MikeT-02/ProiectCEF-ERS/README.md

Proiect Circuite Electronice - Stabilizator de tensiune cu Element de reglaj Serie (ERS)
Proiectul a fost realizat folosind aplicatia OrCAD Capture CIS Lite

Fisierul "layout.opj" contine schema circuitului cu urmatoarele caracteristici:
Tensiune de iesire reglabila in intervalul: 3.66 - 5.5 [V];
Sarcina la iesire: 550 [Ω];
Deriva termica a tensiunii de iesire: <2 mV/°C;
Protectie la suprasarcina prin limitarea curentului tranzistorului element de reglaj serie la maxim 0.4 [A];
Tensiunea de intrare in intervalul: 7.33 - 8.25 [V];
Domeniul temperaturilor de functionare: 0° - 70° C;
Amplificarea in tensiune minima (in bucla deschisa) a amplificatorului de eroare: minim 200;
Circuit alimentat de la o sursa de tensiune simpla;
S-au folosit exclusiv componente discrete, fara circuite integrate;

Fisierul "LAYOUT.brd" contine realizarea in tehnologie PCB a schemei circuitului prezentat mai sus, avand urmatoarele caracteristici:
Dimensiunile PCB: 40mm x 40mm;
Material FR4, dublu strat, grosimea foliei de cupru 18um, grosimea placii 1.5mm;

Fisierul "STAB_TST_11.BOM" contine BOM-ul (Bill of Materials) aferent schemei circuitului;

Fisierul "Documentatie ProiectCEF ERS.pdf" contine o scurta descriere aferenta schemei circuitului in format PDF, realizata conform cerintelor profesorilor coordonatori de la facultarea la care studiez la momentul redactarii acestei descrieri (2025);
