MikeT-02/ProiectCEF-ERS/Documentatie ProiectCEF ERS.pdf

UNIVERSITATEA POLITEHNICA BUCURESTI

Facultatea de Electronica Telecomunicatii si Tehnologia Informatiei

### Proiect Dispozitive si Circuite Electronice

### Stabilizator de tensiune cu Element de Reglaj Serie(ERS)

Student: Trifu Mihai-Alexandru | Profesori Coordonatori:
Grupa: 433C | s.I. Dr. Ing. Miron Cristea
| Dr.Ing. Niculina Drăghici

An universitar: 2024-2025

### 1. Date inițiale de proiectare

Se proiectează un stabilizator de tensiune cu următoarele caracteristici:

N = 11

- Tensiunea de ieșire reglabilă în intervalul: N/3-N/2 [V] -> 3.66V-5.5V;
- Element de reglaj serie;
- Sarcina la ieșire: 50N [Ω] -> 550 Ω;
- Deriva termică a tensiunii de ieșire <2mV/ grad C;
- Protecție la suprasarcină prin limitarea curentului tranzistorului element de reglaj serie la maxim 0.4A;
- Tensiunea de intrare în intervalul: 2/3N-3/4N [V] -> 7.33V-8.25V;
- Domeniul temperaturilor de funcționare: 0°−70°C;
- Amplificarea în tensiune minimă (în buclă deschisă) a amplificatorului de eroare: minim 200;
- Se va determina factorul de stabilizare S;
- Circuitul va fi alimentat de la o sursă de tensiune simplă;
- Se folosesc componente discrete, nu se folosesc circuite integrate.

1

### 2. Schema bloc

Pentru a controla si a ține stabilă valoarea tensiunii de la ieșire, vom utiliza o rețea de reacție negativă globală, această rețea de reacție culege o fracțiune din semnalul de la ieșire si îl întoarce la intrarea inversoare pentru a închide bucla.

Rețeaua de reacție negativă face ca valoarea tensiunii sa depindă doar de valoarea unor componente pasive si de tensiunea de referință, astfel încât sa nu depindă de alți factori.

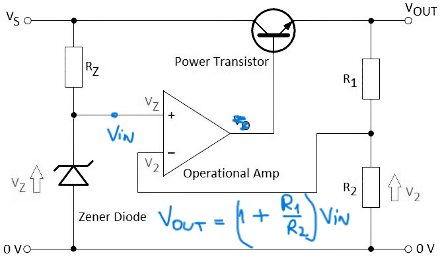
[picture p1: figure]

2

### 3. Proiectarea blocurilor

3.1REFERINTA DE TENSIUNE

Referinta de tensiune de pe borna pozitiva a amplificatorului de eroare este reprezentata din dioda Zener D6, respectiv R29 si R30.

Pe dioda Zener D6 cade o tensiune de 2.7 V, aceasta reprezentand tensiunea de referinta a amplificatorului de eroare.

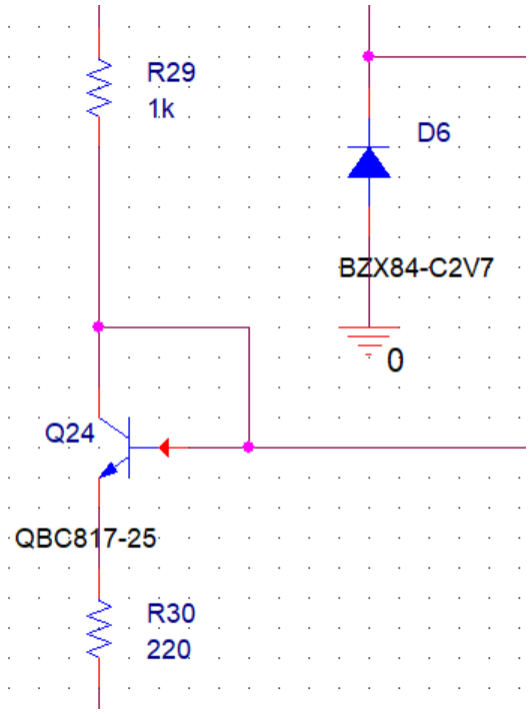
[picture p2: figure]

3

### 3.2 REȚEAUA DE REACȚIE NEGATIVĂ

E constituita din rezistentele R6, R12, R37, R38, R9 si R34 și din potențiometrul P1.

Relația de la ieșire: Vout = (1+(R6+R12+R37)/(R38+R9+R34))*Vin

Prin modificarea valorii SET din potențiometrul P1: se schimba valoarea tensiunii de la ieșire, conform schemei bloc. (dependentă formula de cele 3 rezistente).

4

### 3.3 ELEMENTUL DE REGLAJ SERIE

QESR - QESR2 = al doilea etaj de amplificare in conexiune Darlington, reprezinta si elementul de reglaj serie.

Tranzistorul QESR-QESR2 care reprezinta elementul de reglaj serie este un tranzistor de putere care poate mentine o disipare de putere, implicit un VCE marit, pentru a nu se arde.

5

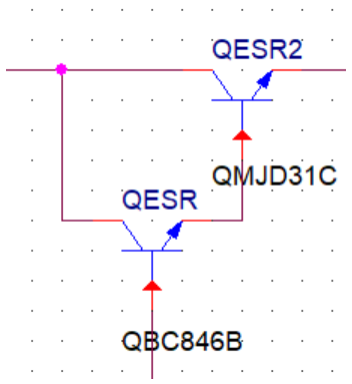
[picture p3: figure]

### 3.4 Circuitul de protecție

Formatiunea formata din QSARCINA, RC1,2,3,4 are rolul de a limita o suprasarcina, adica un curent marit prin sarcina circuitului. Cu cat curentul creste, caderea de tensiune pe rezistente creste, ceea ce duce la deschiderea tranzistorului QSARCINA, si prin comutarea sa in ON se opreste functionarea circuitului. In functionare normala,
QSARCINA este OFF.

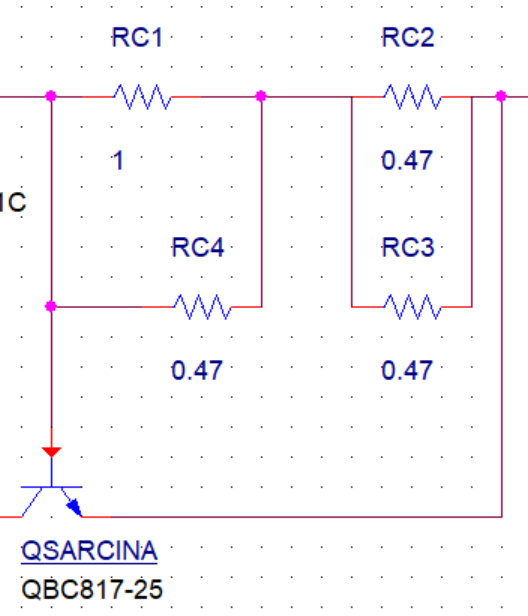
[picture p4: figure]

6

### 4. Schema electrică a montajului electric

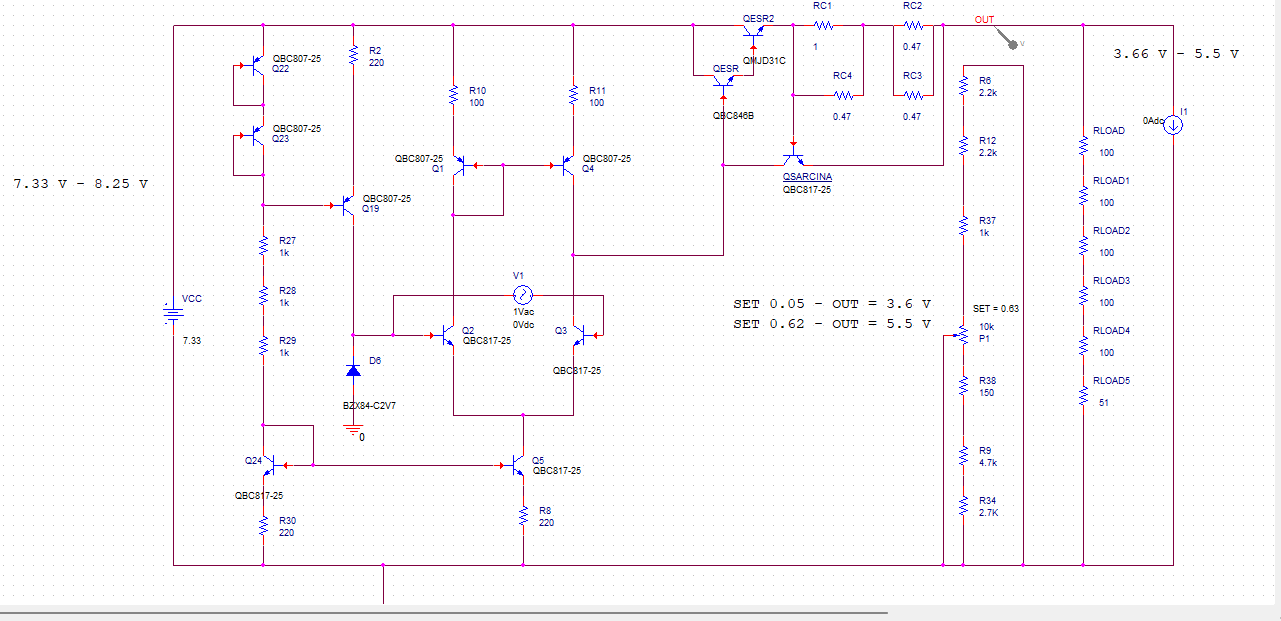
[picture p5: figure]

Roluri și componente:

Q3 și Q2 etaj diferențial de tip NPN -> etaj care amplifica in tensiune si curent;

Q1 si Q4 sarcina activa a etajului diferential, egaleaza curentii pe cele 2 ramuri ale acestuia;

Q1 = referinta de oglinda/transistor dioda de tip PNP -> permite sa iesi din etajul diferential asimetric, deci nu se injumatateste amplificarea etajului;

Rezistoarele R10 SI R11 se numesc rezistente de degenerare si au rol de stabilitate termica;

Etajele de amplificare – pentru a funcționa au nevoie de un curent constant;

Sursa de curent Q5 polarizeaza etajul diferential;

Curentul generat se realizeaza cu ajutorul ramurei Q23 - Q22 - R27 - R28 - R29 - Q24 -R30;

Pe tranzitoarele Q22 si Q23 in conexiune dioda cade cate o tensiune VBE;

Tranzistorul Q24 este referinta de oglinda din oglinda Q24-Q5;

Tranzistorul Q5 copiaza curentul si il ofera pentru a polariza etajul diferential;

7

### 5. Punctul static de funcționare

5.1Punctul static de funcționare pentru tensiune

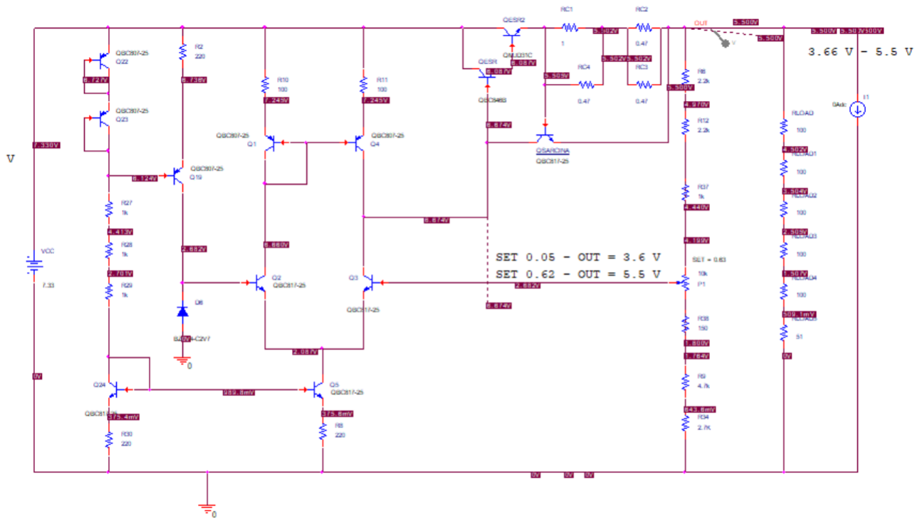
[picture p6: figure]

8

5.2Punctul static de funcționare pentru curenți

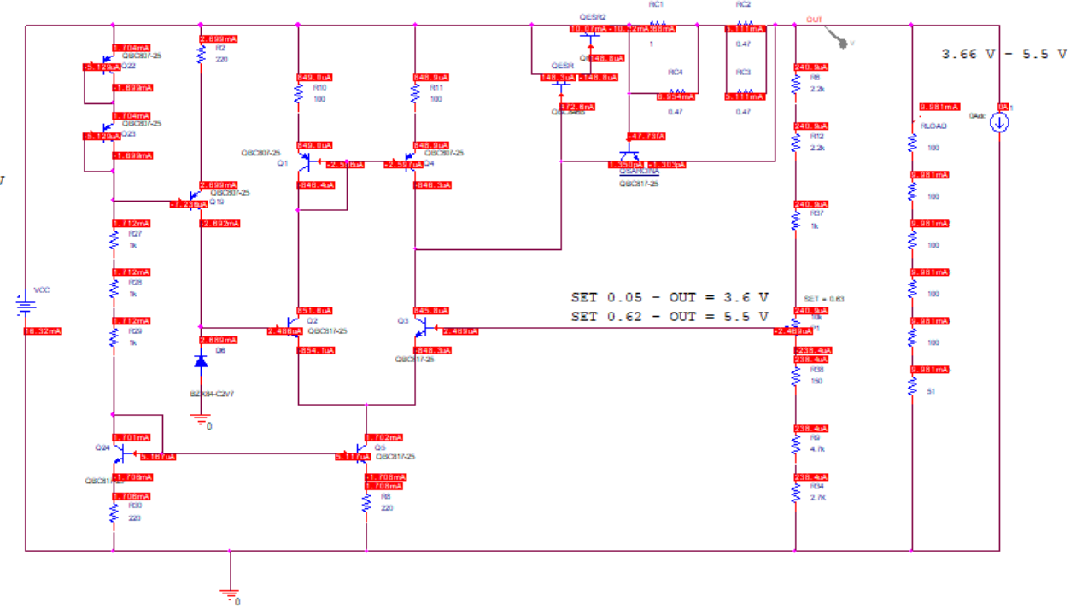
[picture p7: figure]

9

5.3Punctul static de funcționare pentru putere

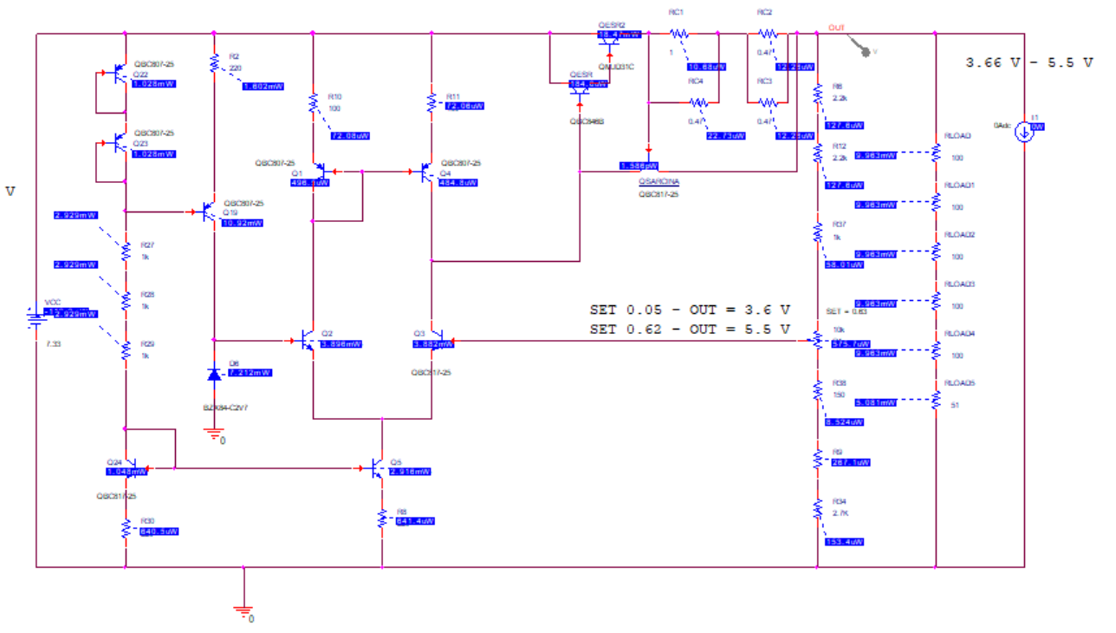
[picture p8: figure]

10

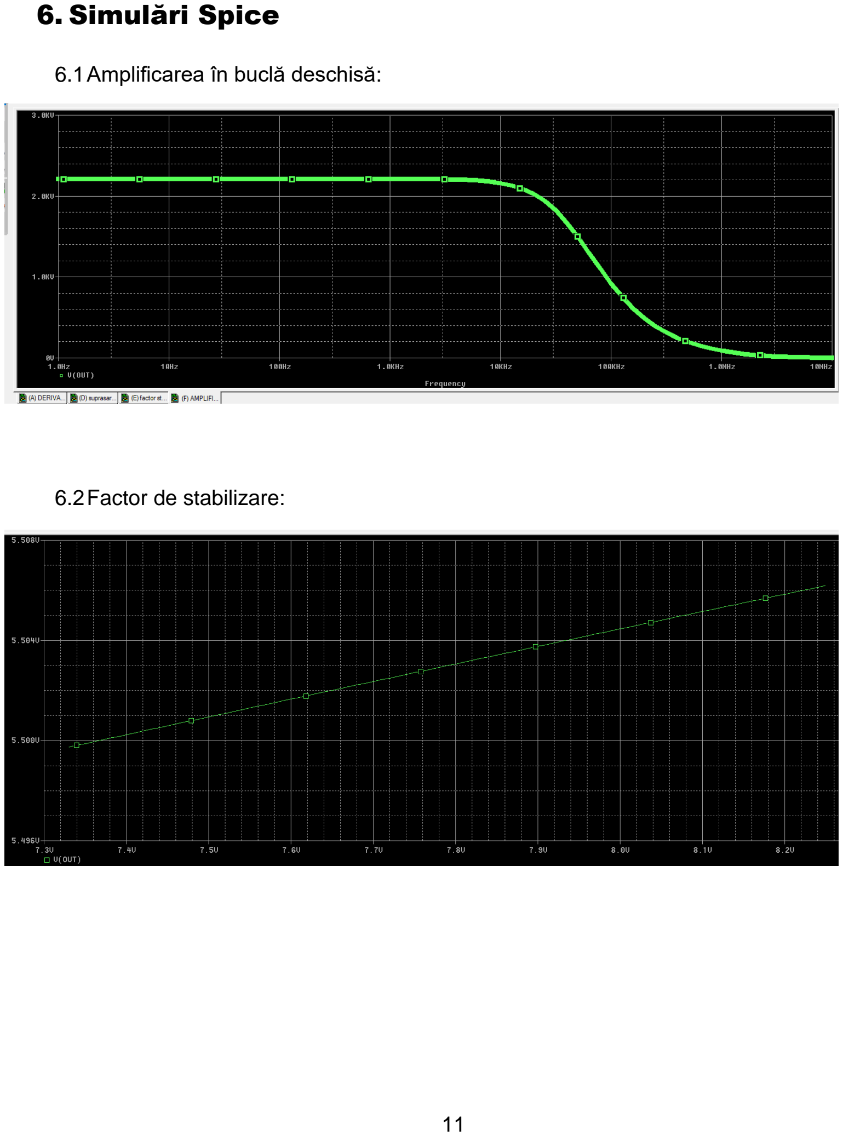
[picture p9: page 12]

### 6. Simulări Spice

6.1Amplificarea în buclă deschisă:

6.2Factor de stabilizare:

11

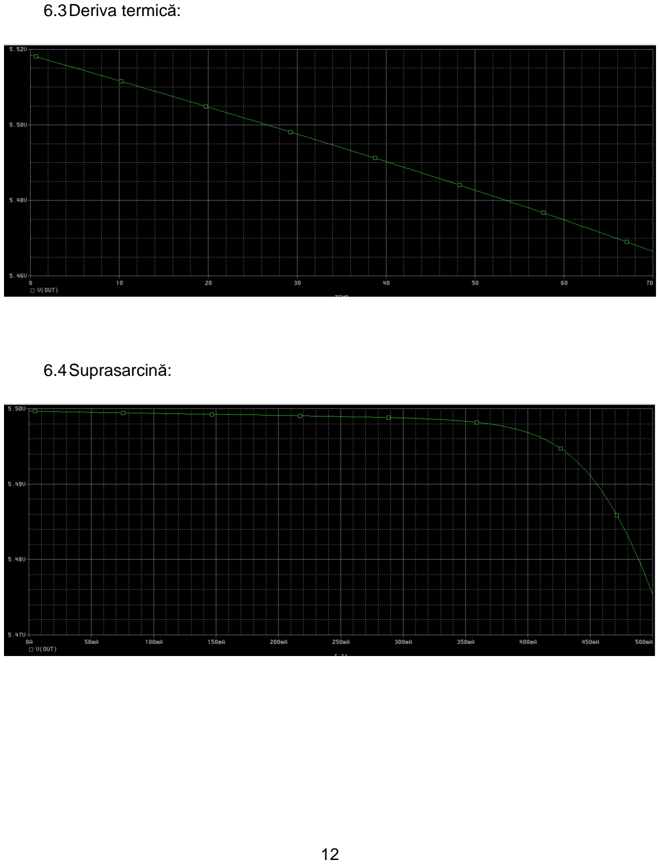
[picture p10: page 13]

6.3Deriva termică:

6.4Suprasarcină:

12

### 7. Bill of materials

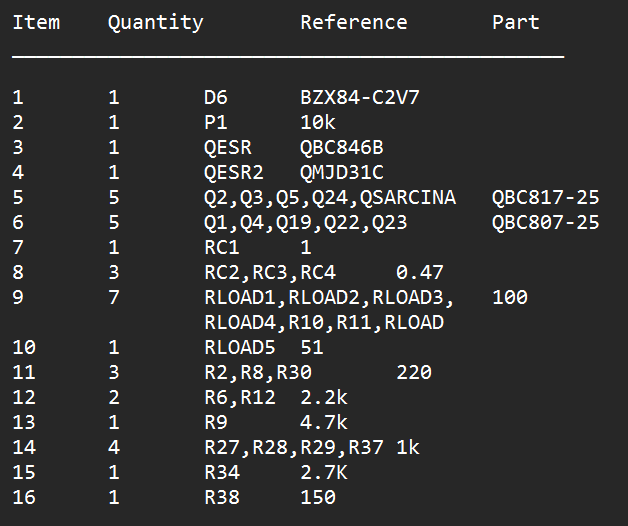
[picture p11: figure]

13

### 8. Bibliografie

- CODREANU N., PANTAZICĂ M., IONESCU C., MARCU A., Tehnici CAD de realizarea modulelor electronice, București, Editura CAVALLIOTI, 2017
- BREZEANU GH., DRĂGHICI F., DILIMOȚ GH., MITU F., Circuite electronice fundamentale, București, Editura ROSETTI EDUCATIONAL, 2009
- Notite cursuri Dispozite electronice si Circuite electronice fundamentale
- http://www.dce.pub.ro/
- CETTI - Tehnici CAD (https://www.cetti.ro/v2/tehnicicad.php)

14
