MikeT-02/ProiectCEF-ERS/(list of files, drawings)

Other design files:
layout.opj
